mostafa1310/Metal-Monstor/woodwork/Hammer_wood_parts.pdf

# Hammer stick + head – laser cut

Only the stick and the head are wood. They are 2 flat shapes, both cut from 10 mm plywood: 2 × the stick T, glued face to face → a 20 × 20 stick, and 2 side plates, one glued on each side of the head → a 40 mm head. Finished sizes: stick 20 × 20, head 64 × 25 × 40. The motor upright, the hub and the stop posts are 3D printed (stl/P7 hub with a 20.3 mm slot, P8 upright, P9 / P10 stop posts).

Send to the laser shop

File (SVG or DXF) | Thickness | How many
laser/Hammer_all_parts_10mm (all 4 pieces on one sheet, 273 × 173 mm) | 10 mm | 1 sheet = 2 T + 2 plates

or the same pieces split: laser/Hammer_T_layer_10mm (2 T) + laser/Hammer_head_side_plate_10mm (2 plates)

Material | birch plywood 10 mm (not MDF – it splits at the bolt holes)
Scale | 1:1, units mm – import without scaling
Lines | all lines are cut-through lines (layer CUT in the DXF, red in the SVG)
Check | the stick T must measure 262.5 mm long and 20 mm wide

"10 mm" plywood is often 9.5–9.8 mm. Measure the glued stick: if it is under 19.5 mm, tell me before printing the hub – the slot (20.3) can follow it.

Also needed

Wood glue (or epoxy) | –
M4×40 + nyloc | 2 – hub → stick
M4×50 + nyloc | 1 – through the head
64

4

0
2

0

head from below: plate + 2 stick layers + plate

Checks

☐ Glued stick measures 19.5–20.2 mm thick.
☐ Stick slides into the hub slot without forcing.
☐ The side plate holes line up with the head hole of the stick.
Metal Monster robot – hammer stick + head (laser cut) · overview | page 1 of 2

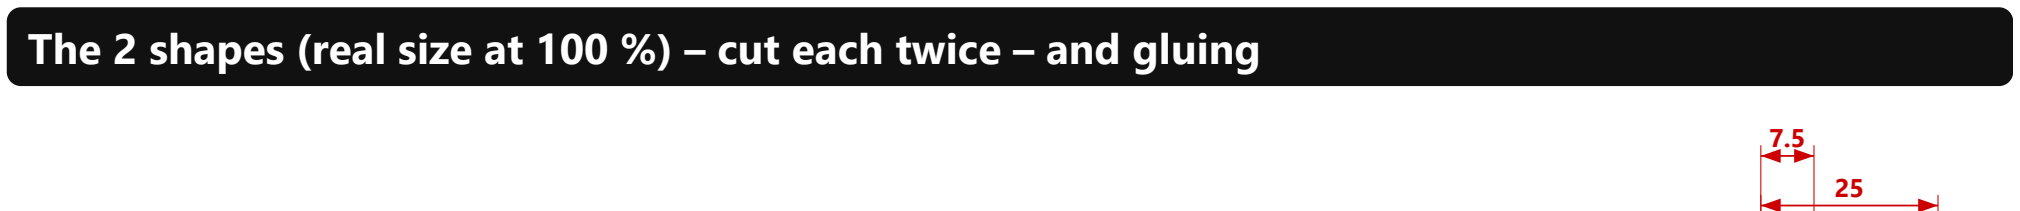
[picture p1: figure]

## The 2 shapes (real size at 100 %) – cut each twice – and gluing

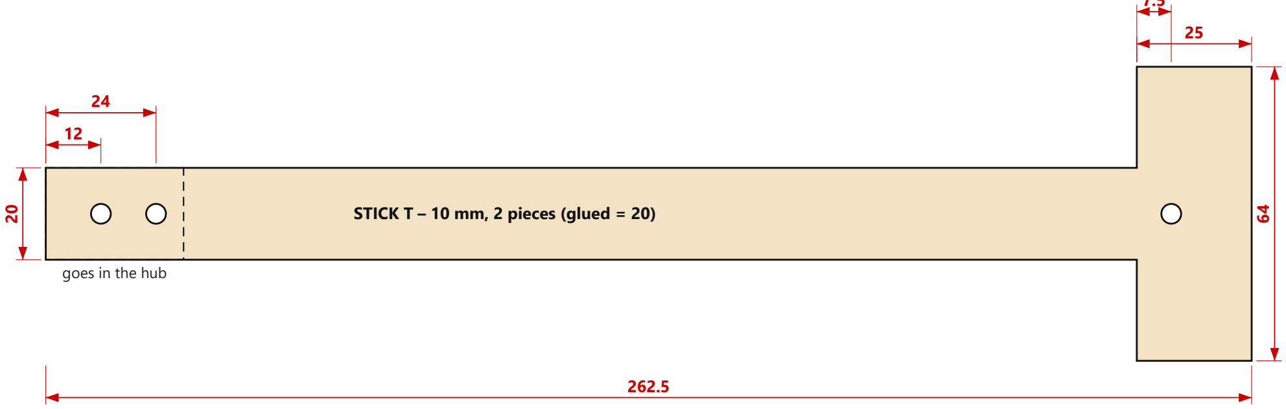
[picture p2: figure]
goes in the hub; STICK T – 10 mm, 2 pieces (glued = 20)

all holes Ø4.3 · the head hole is on the centre line

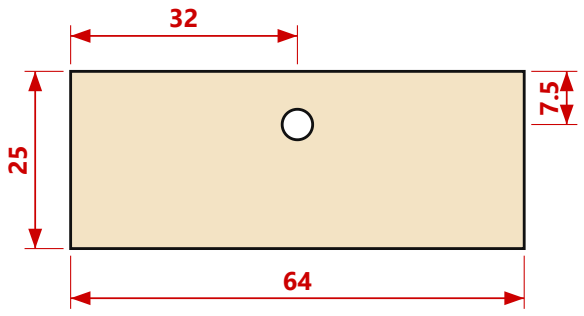
[picture p3: figure]

SIDE PLATE – 10 mm thick, 2 pieces

Glue the 2 stick Ts face to face (thin even layer of wood glue). Push M4 bolts through the 3 holes to line them up, clamp along the whole length, let dry → 20 × 20 stick.

1

Glue the 2 side plates on both sides of the wide end, M4 bolt through the head hole to line them up, clamp, let dry. The head is now 64 × 25 × 40.

2

3 When dry: M4×50 + nyloc through the head. Sand the edges.
Top 30 mm of the stick into the printed hub slot (20.3 × 20.3) with epoxy, 2 × M4×40 through hub + stick.

4

Metal Monster robot – hammer stick + head (laser cut) · shapes and gluing | page 2 of 2
