mostafa1310/Metal-Monstor/model/Metal_Monster_robot.stl

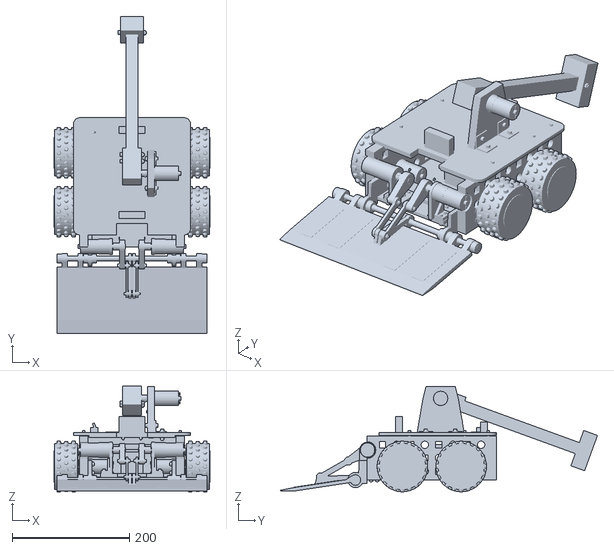
[picture p4: CAD file, 2026-10-10]
model/Metal_Monster_robot.stl
265.0 x 539.6 x 179.6
