mostafa1310/Metal-Monstor/stl/P7_Hammer_hub.stl

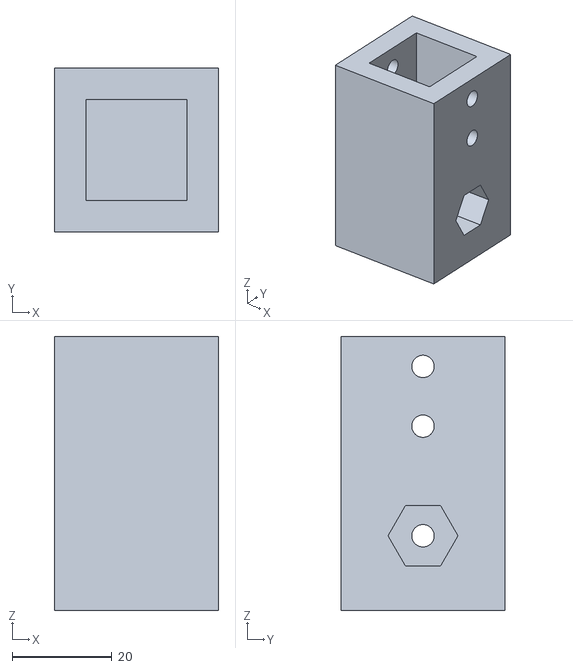
[picture p5: CAD file, 2026-10-10]
stl/P7_Hammer_hub.stl
33.0 x 33.0 x 55.0
