mostafa1310/Metal-Monstor/woodwork/laser/Hammer_T_layer_10mm.dxf

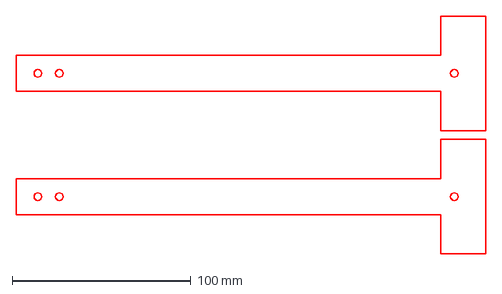
[picture p6: CAD file, 2026-10-10]
woodwork/laser/Hammer_T_layer_10mm.dxf
262.5 x 133.0 mm
