mostafa1310/Metal-Monstor/stl/P10_Front_stop_post.stl

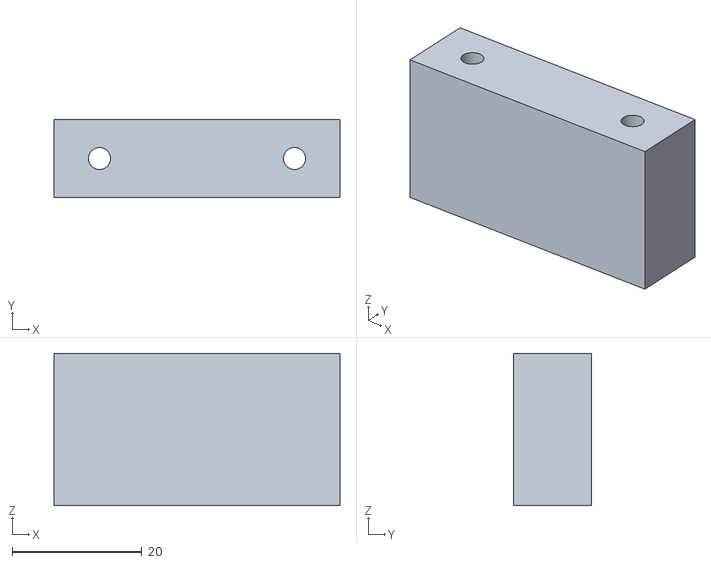
[picture p7: CAD file, 2026-10-10]
stl/P10_Front_stop_post.stl
44.0 x 12.0 x 23.4
