mostafa1310/Metal-Monstor/woodwork/laser/Hammer_all_parts_10mm.dxf

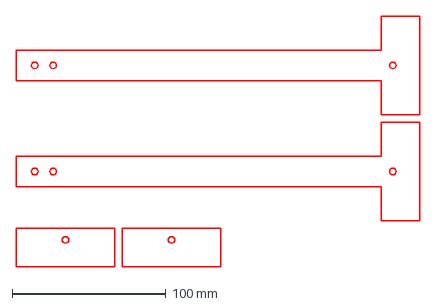
[picture p8: CAD file, 2026-10-10]
woodwork/laser/Hammer_all_parts_10mm.dxf
262.5 x 163.0 mm
