mostafa1310/Metal-Monstor/stl/P1_Blade.stl

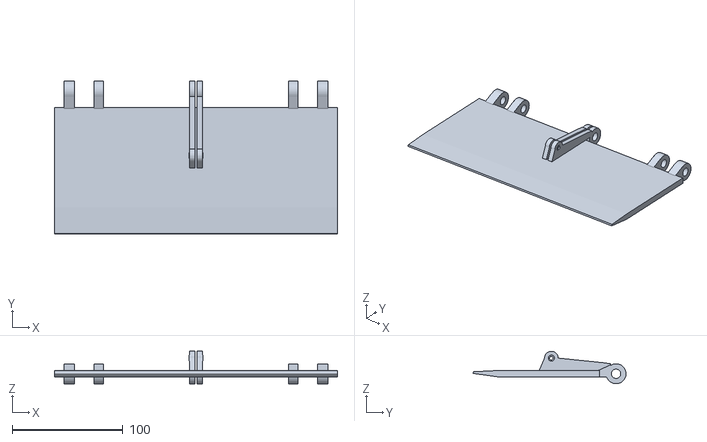
[picture p9: CAD file, 2026-10-10]
stl/P1_Blade.stl
255.0 x 138.0 x 29.3
