mostafa1310/Metal-Monstor/woodwork/laser/Hammer_T_layer_6mm.dxf

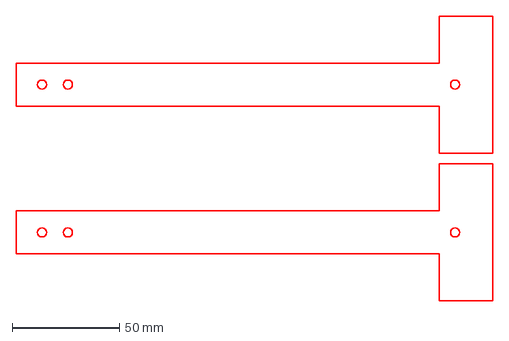
[picture p10: CAD file, 2026-10-09]
woodwork/laser/Hammer_T_layer_6mm.dxf
222.5 x 133.0 mm
