mostafa1310/Metal-Monstor/stl/P9_Rear_stop_post.stl

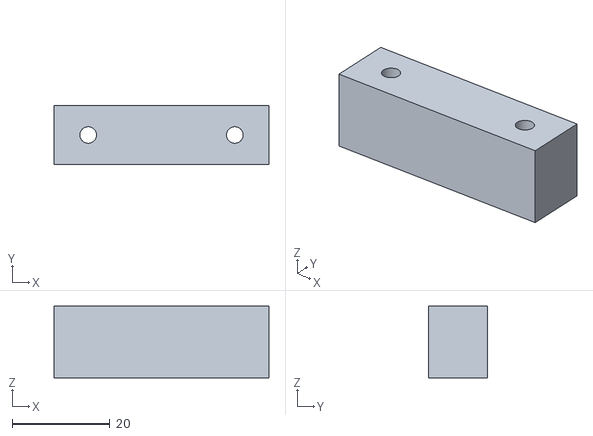
[picture p11: CAD file, 2026-10-09]
stl/P9_Rear_stop_post.stl
44.0 x 12.0 x 14.7
