mostafa1310/Metal-Monstor/woodwork/laser/Hammer_all_parts_6mm.dxf

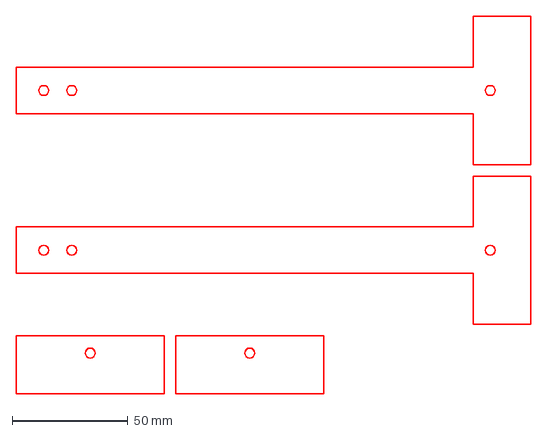
[picture p12: CAD file, 2026-10-09]
woodwork/laser/Hammer_all_parts_6mm.dxf
222.5 x 163.0 mm
