mostafa1310/Metal-Monstor/stl/P8_Hammer_motor_upright.stl

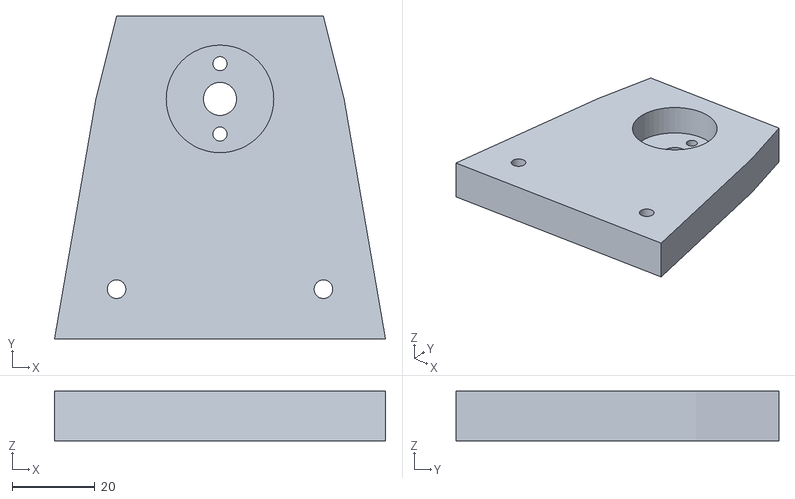
[picture p13: CAD file, 2026-10-09]
stl/P8_Hammer_motor_upright.stl
80.0 x 78.0 x 12.0
