mostafa1310/Metal-Monstor/woodwork/laser/Hammer_head_side_plate_10mm.dxf

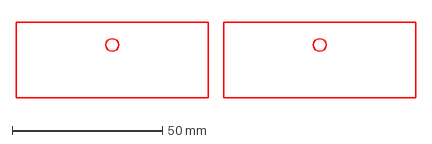
[picture p14: CAD file, 2026-10-09]
woodwork/laser/Hammer_head_side_plate_10mm.dxf
133.0 x 25.0 mm
