mostafa1310/Metal-Monstor/stl/P5_Crank_RIGHT.stl

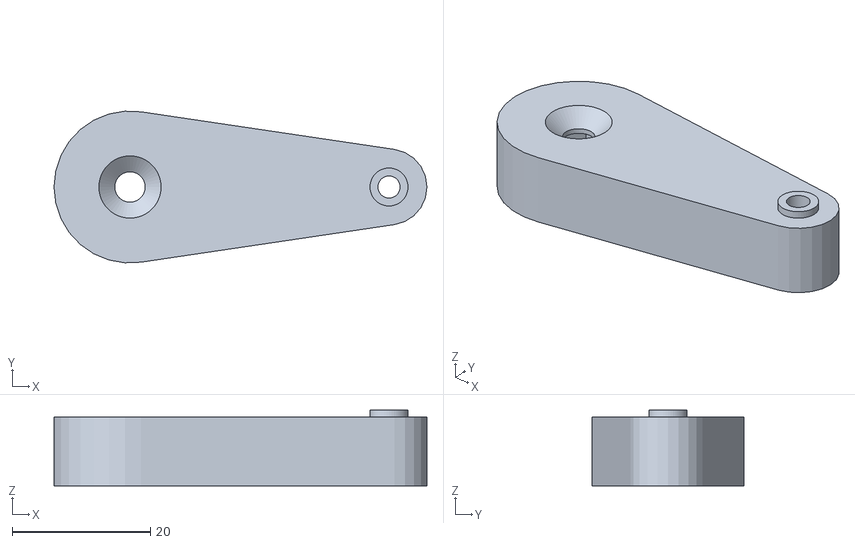
[picture p15: CAD file, 2026-10-04]
stl/P5_Crank_RIGHT.stl
54.0 x 21.9 x 11.0
