mostafa1310/Metal-Monstor/stl/P4_Motor_bracket_RIGHT.stl

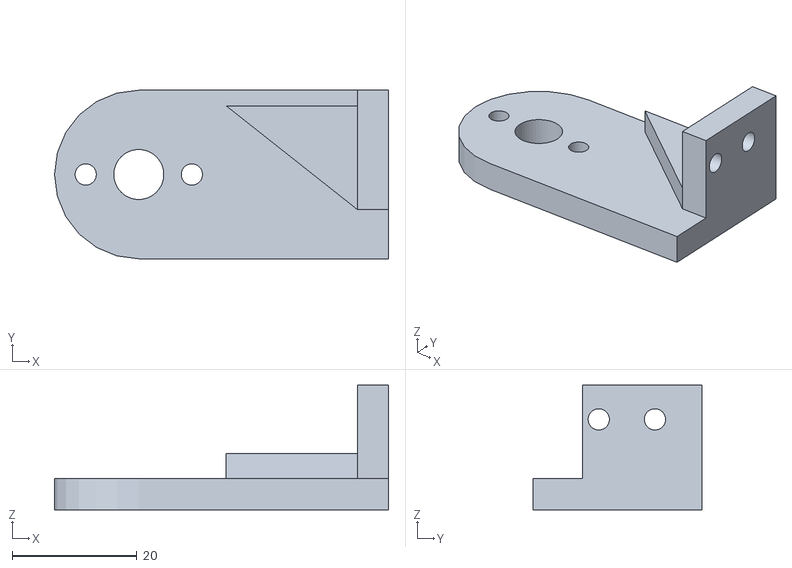
[picture p16: CAD file, 2026-10-03]
stl/P4_Motor_bracket_RIGHT.stl
53.5 x 27.0 x 20.0
