mostafa1310/Metal-Monstor/stl/T0_Hole_test_piece.stl

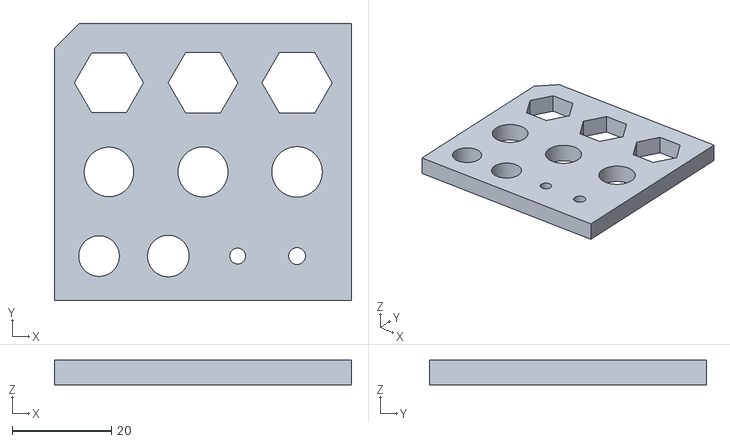
[picture p17: CAD file, 2026-10-03]
stl/T0_Hole_test_piece.stl
60.0 x 56.0 x 5.00
