mostafa1310/Metal-Monstor/stl/P6_Rod_RIGHT.stl

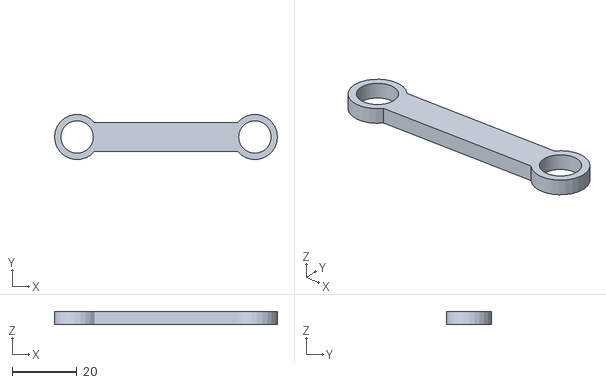
[picture p18: CAD file, 2026-10-03]
stl/P6_Rod_RIGHT.stl
69.0 x 13.9 x 4.00
