mostafa1310/Metal-Monstor/stl/P3_Front_plate.stl

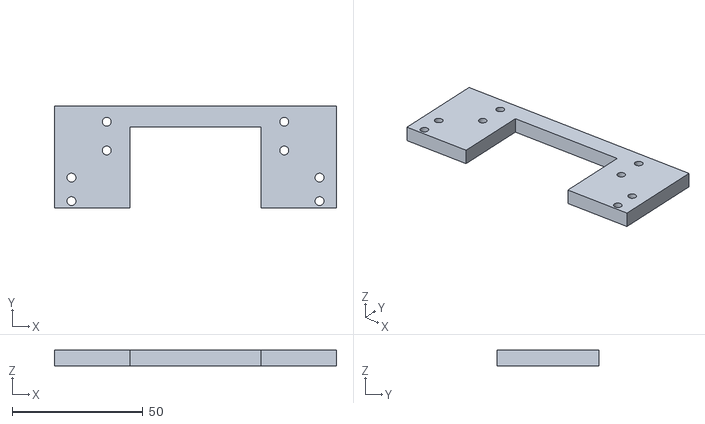
[picture p19: CAD file, 2026-10-03]
stl/P3_Front_plate.stl
108.0 x 39.0 x 6.00
