mostafa1310/Metal-Monstor/stl/P2_Side_plate_RIGHT.stl

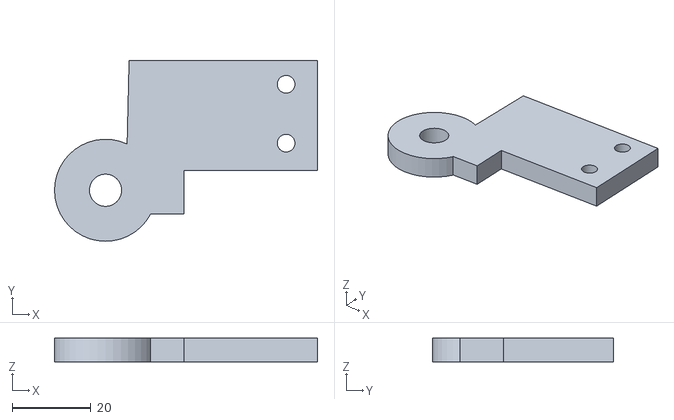
[picture p20: CAD file, 2026-10-03]
stl/P2_Side_plate_RIGHT.stl
67.0 x 46.0 x 6.00
