mostafa1310/Metal-Monstor/(list of files, cad)

Other CAD files:
stl/P5_Crank_LEFT.stl
stl/P4_Motor_bracket_LEFT.stl
stl/P6_Rod_LEFT.stl
stl/P2_Side_plate_LEFT.stl
