mostafa1310/Metal-Monstor/(commit log)

2026-10-02 Update Metal Monster design and specifications
    - Changed title from "Metal Monster V2 – Simple Build" to "Metal Monster"
    - Updated kit box dimensions and specifications for improved design
    - Adjusted shovel blade dimensions and hinge details
    - Revised drive and frame specifications, including motor mount and wheel details
    - Enhanced mechanical check section with updated issues and fixes
    - Modified 3D printing parameters and parts list for accuracy
    - Removed redundant versioning in script initialization
2026-10-03 Refactor code structure for improved readability and maintainability
    [P1_Blade.stl, P2_Side_plate_LEFT.stl, P2_Side_plate_RIGHT.stl, P3_Front_plate.stl, P4_Motor_bracket_LEFT.stl, P4_Motor_bracket_RIGHT.stl, P5_Crank_LEFT.stl, P5_Crank_RIGHT.stl]
2026-10-04 Enhance crank and coupler specifications in documentation and update STL files
    [P5_Crank_LEFT.stl, P5_Crank_RIGHT.stl]
2026-10-08 Add script to generate workshop pack for wooden hammer parts
    - Implemented a Python script that creates an HTML document containing detailed drawings and instructions for building wooden parts of a robot hammer.
    - The script generates SVG graphics for full-size drawings, including dimensions and hole placements.
    - Included CSS for styling the output document and structured the content into sections for clarity.
    - Added functionality to print the document to PDF using Chrome.
    [P7_Hammer_hub.stl]
2026-10-09 Add DXF and SVG files for Metal Monster hammer components
    - Created Hammer_head_side_plate_7.5mm.dxf and Hammer_head_side_plate_7.5mm.svg for the hammer head side plate, cut from 7.5 mm material.
    - Created Hammer_stick_T_15mm.dxf and Hammer_stick_T_15mm.svg for the hammer stick T, cut from 15 mm material.
    [Hammer_head_side_plate_7.5mm.dxf, Hammer_stick_T_15mm.dxf, P10_Front_stop_post.stl, P8_Hammer_motor_upright.stl, P9_Rear_stop_post.stl]
2026-10-09 Remove unused DXF and SVG files for Hammer components
    [Hammer_head_side_plate_7.5mm.dxf, Hammer_stick_T_15mm.dxf]
2026-10-09 Refactor hammer design files for 6 mm plywood
    - Updated Hammer_wood_parts.pdf to reflect changes in material thickness and dimensions for the hammer stick and head.
    - Modified make_pack.py to generate laser-cut files for the hammer parts using 6 mm plywood, including new DXF and SVG files for the stick T layer and head side plates.
    - Added new 3D model files (GLB and STL) for the Metal Monster robot.
    - Created new DXF and SVG files for all hammer parts, ensuring compatibility with laser cutting.
    - Adjusted build guide to include updated assembly instructions and material specifications.
    [Hammer_T_layer_6mm.dxf, Hammer_all_parts_6mm.dxf, Hammer_head_side_plate_6mm.dxf, Metal_Monster_robot.stl, P7_Hammer_hub.stl]
2026-10-10 Add new laser-cut files for 10mm plywood hammer parts and update packaging script
    - Created DXF and SVG files for the Hammer T layer and all parts using 10mm plywood.
    - Removed the 6mm SVG file for the Hammer T layer.
    - Updated the make_pack.py script to reflect changes for 10mm plywood, including dimensions and material specifications.
    - Adjusted descriptions in the HTML output for the laser shop and assembly instructions to match the new design.
    [Hammer_T_layer_10mm.dxf, Hammer_all_parts_10mm.dxf, Hammer_head_side_plate_10mm.dxf, Metal_Monster_robot.stl, P10_Front_stop_post.stl, P1_Blade.stl, P7_Hammer_hub.stl]
